wiweits/ALittleIOT/(commit log)

2022-01-03 2022/1/3首次提交
2022-01-03 上传图片
2022-01-03 更新图片
